jorgefinelli90/minic3portable/imagenes/caja_dibujo_capa1.png

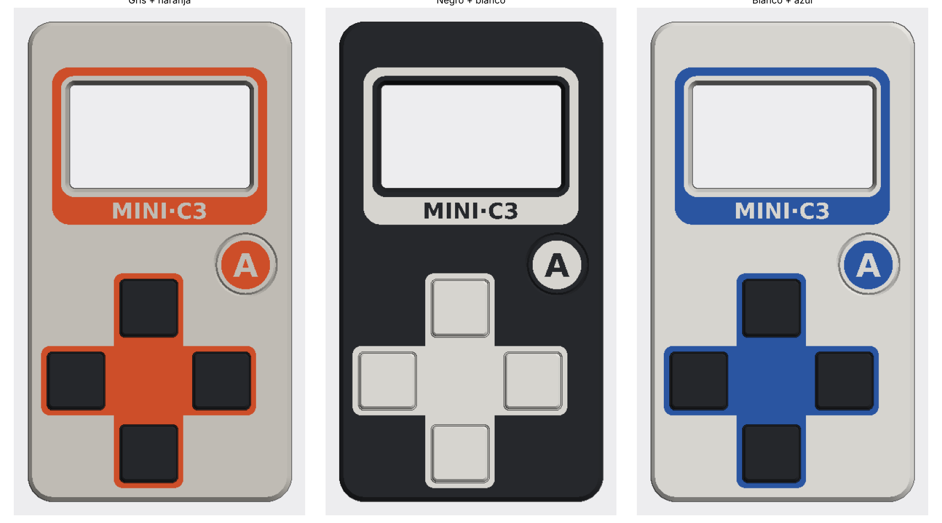
imagenes/caja_dibujo_capa1.png
