jorgefinelli90/minic3portable/imagenes/caja_traba_pulsador.png

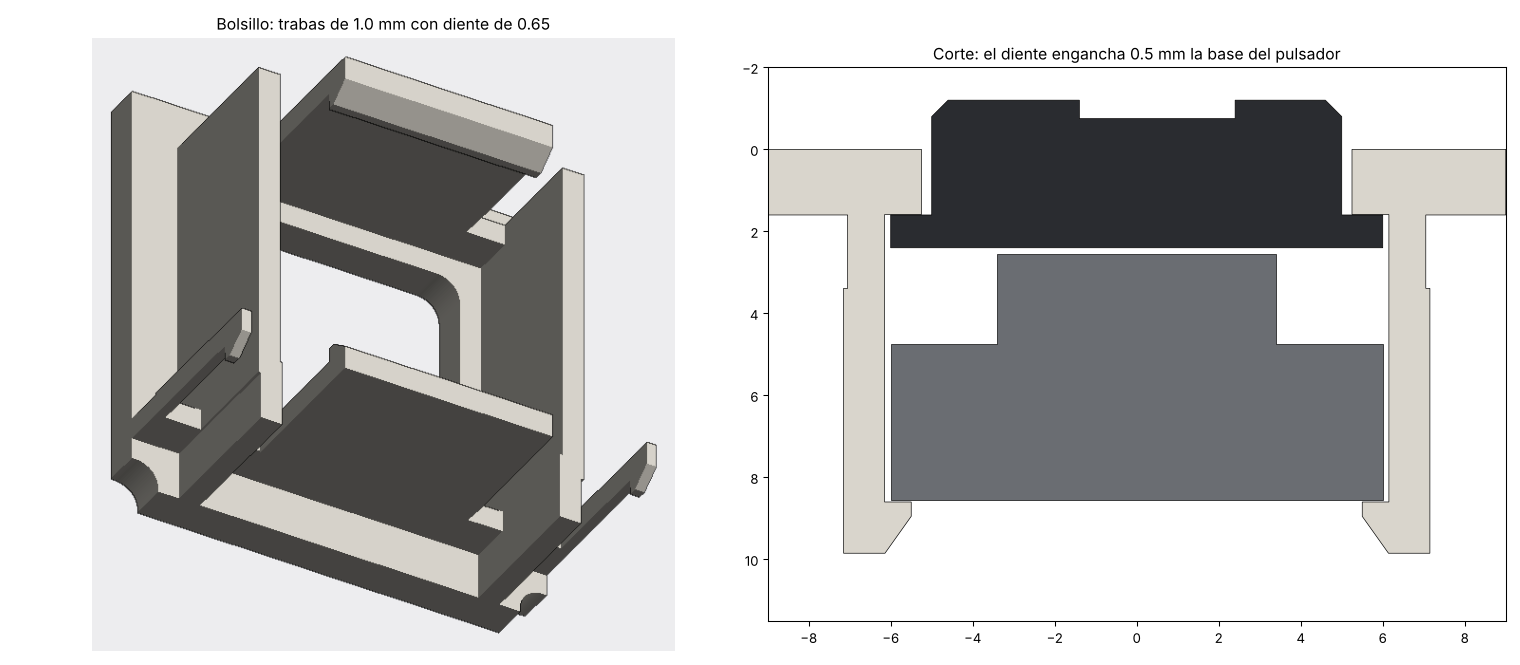
imagenes/caja_traba_pulsador.png
