jorgefinelli90/minic3portable/imagenes/caja_vistas.png

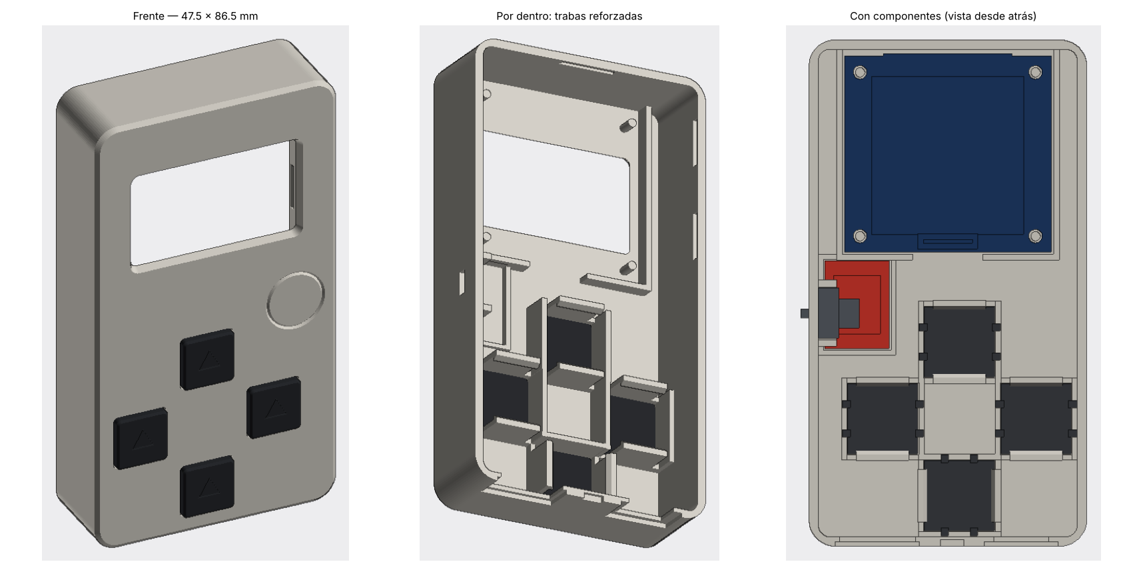
imagenes/caja_vistas.png
