jorgefinelli90/minic3portable/imagenes/foto_mini_c3.jpg

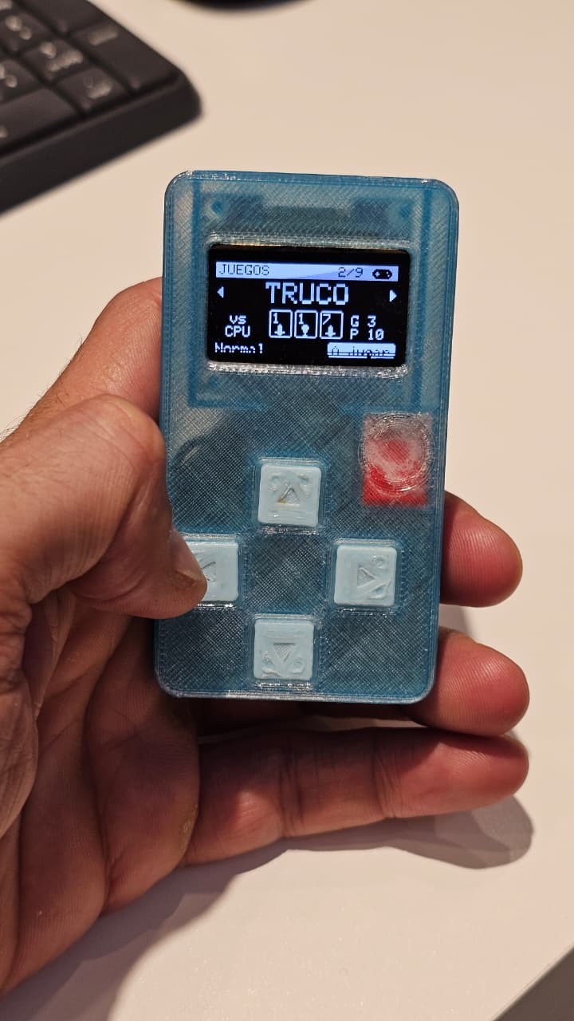
imagenes/foto_mini_c3.jpg
