jorgefinelli90/minic3portable/imagenes/pantallas/arkanoid_juego.gif

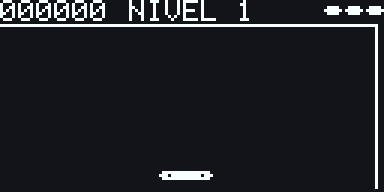
imagenes/pantallas/arkanoid_juego.gif
