jorgefinelli90/minic3portable/imagenes/pantallas/arkanoid_pantallas.png

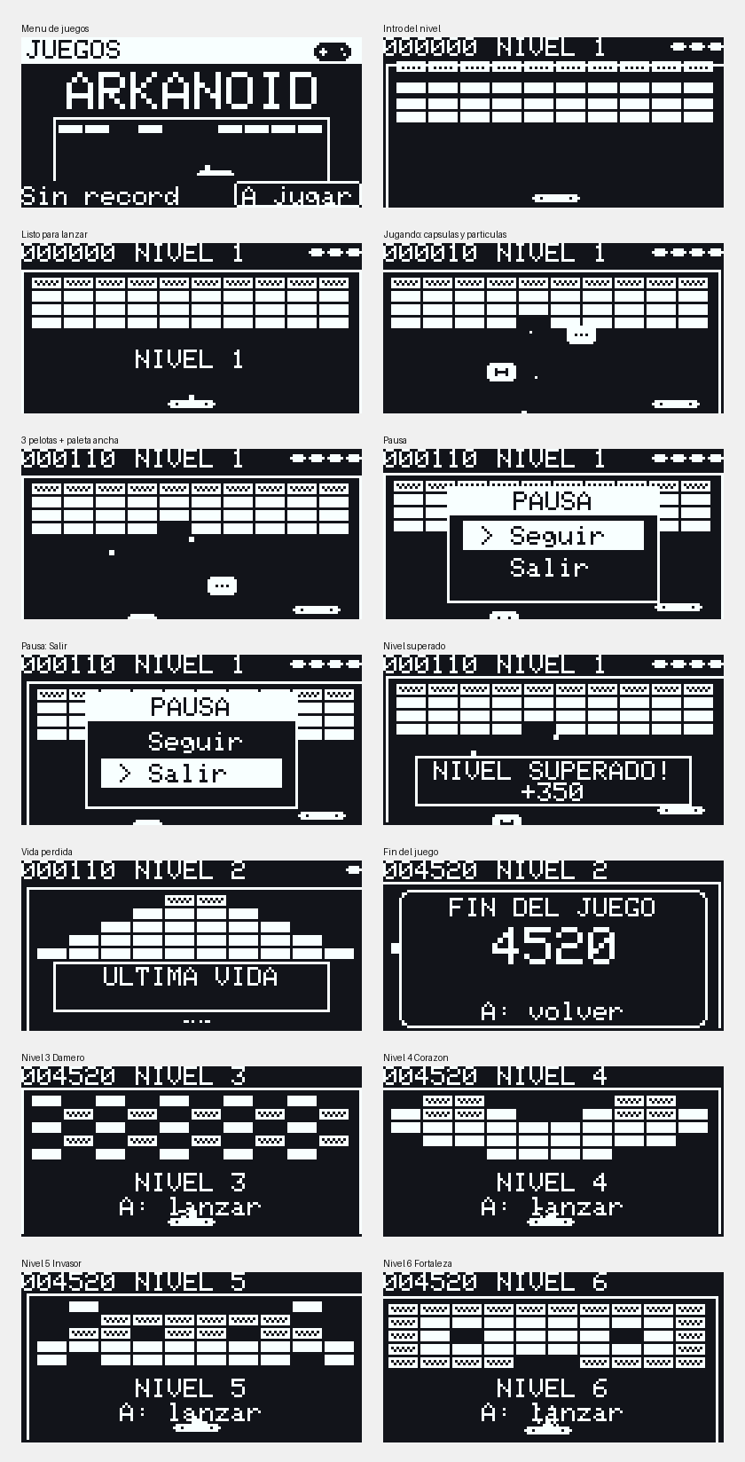
imagenes/pantallas/arkanoid_pantallas.png
