jorgefinelli90/minic3portable/imagenes/pantallas/inicio.gif

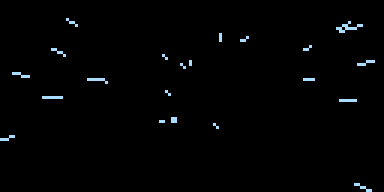
imagenes/pantallas/inicio.gif
