jorgefinelli90/minic3portable/imagenes/pantallas/juegos_v1110.png

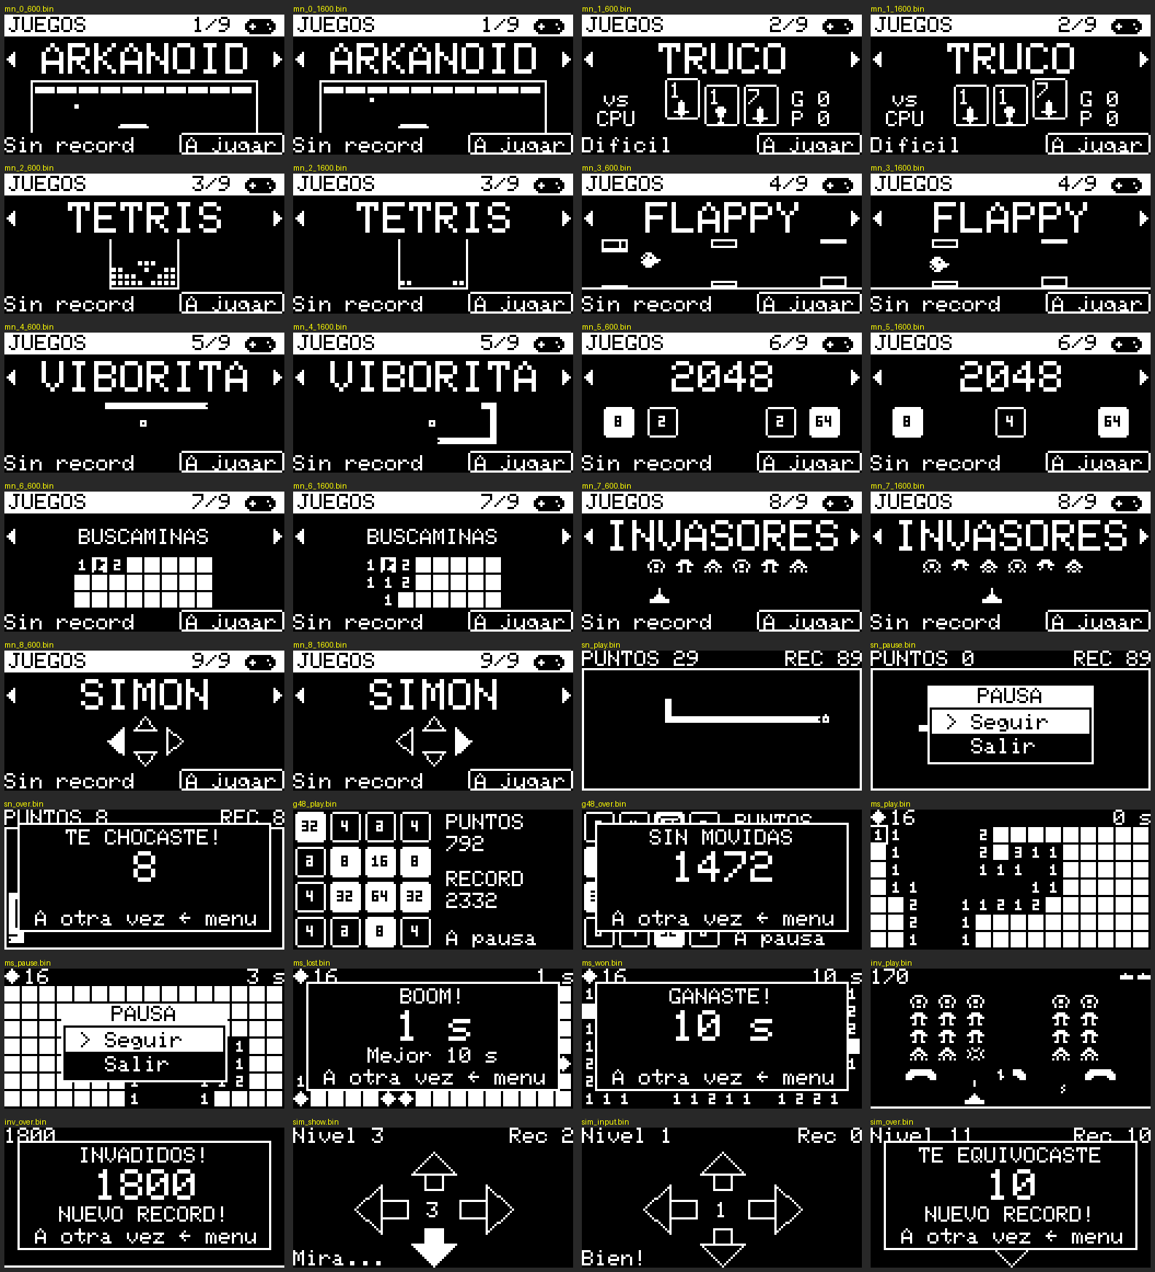
imagenes/pantallas/juegos_v1110.png
