jorgefinelli90/minic3portable/imagenes/pantallas/mensaje_llega.gif

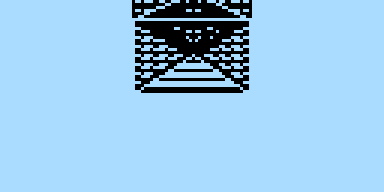
imagenes/pantallas/mensaje_llega.gif
