jorgefinelli90/minic3portable/imagenes/pantallas/mensajes_pantallas.png

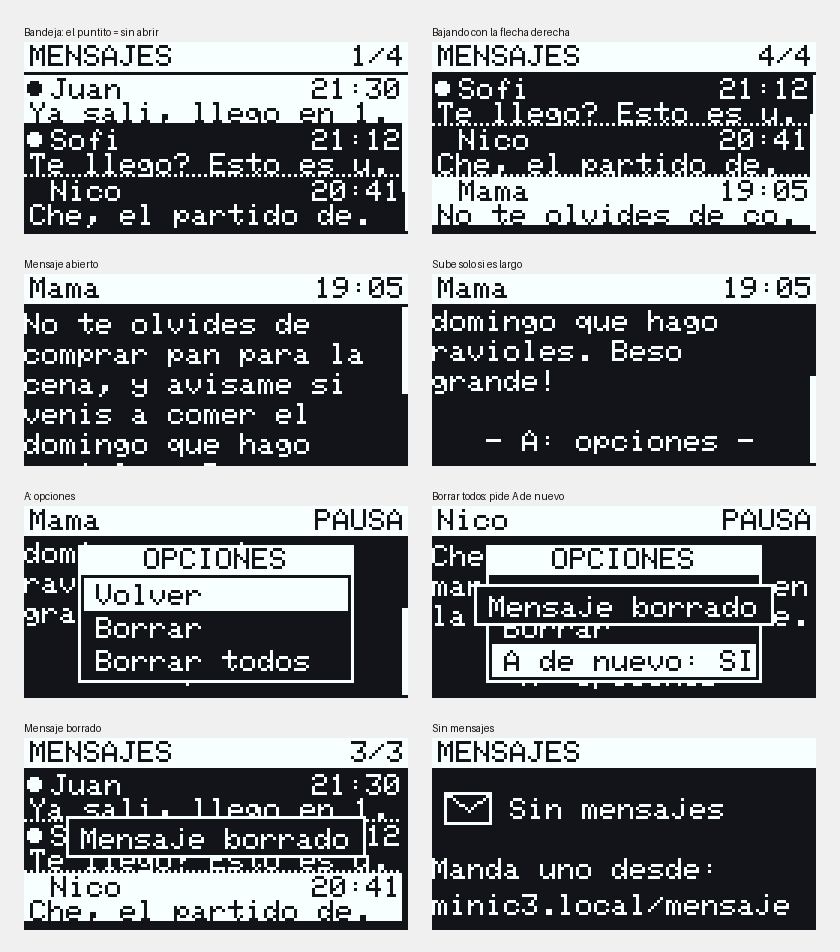
imagenes/pantallas/mensajes_pantallas.png
