jorgefinelli90/minic3portable/imagenes/pantallas/noticias_scroll.gif

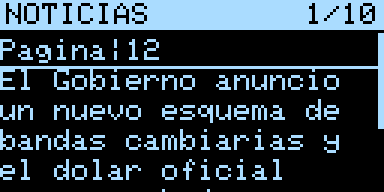
imagenes/pantallas/noticias_scroll.gif
