jorgefinelli90/minic3portable/imagenes/pantallas/panel_equipo.png

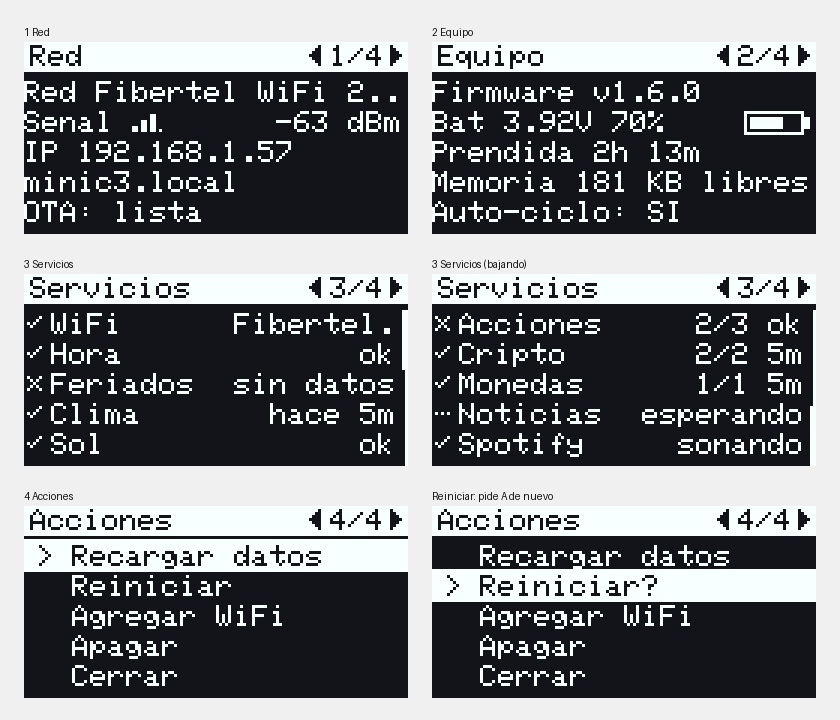
imagenes/pantallas/panel_equipo.png
