jorgefinelli90/minic3portable/imagenes/pantallas/spotify_pantallas.png

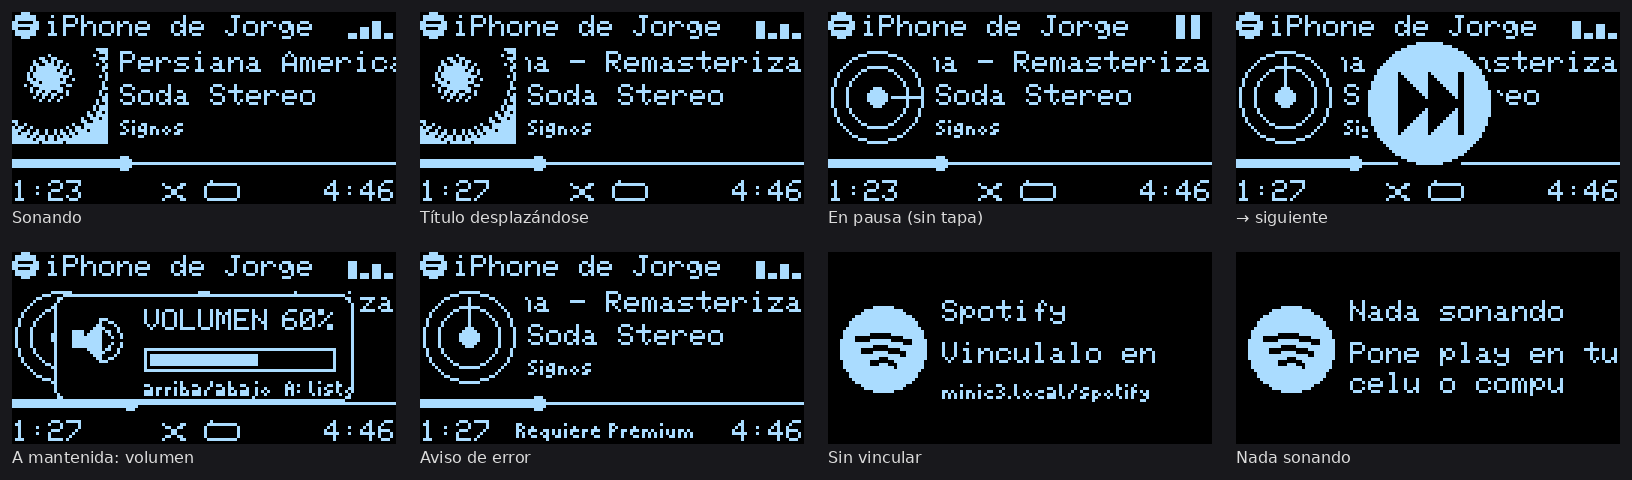
imagenes/pantallas/spotify_pantallas.png
