jorgefinelli90/minic3portable/imagenes/pantallas/tetris_flappy_pantallas.png

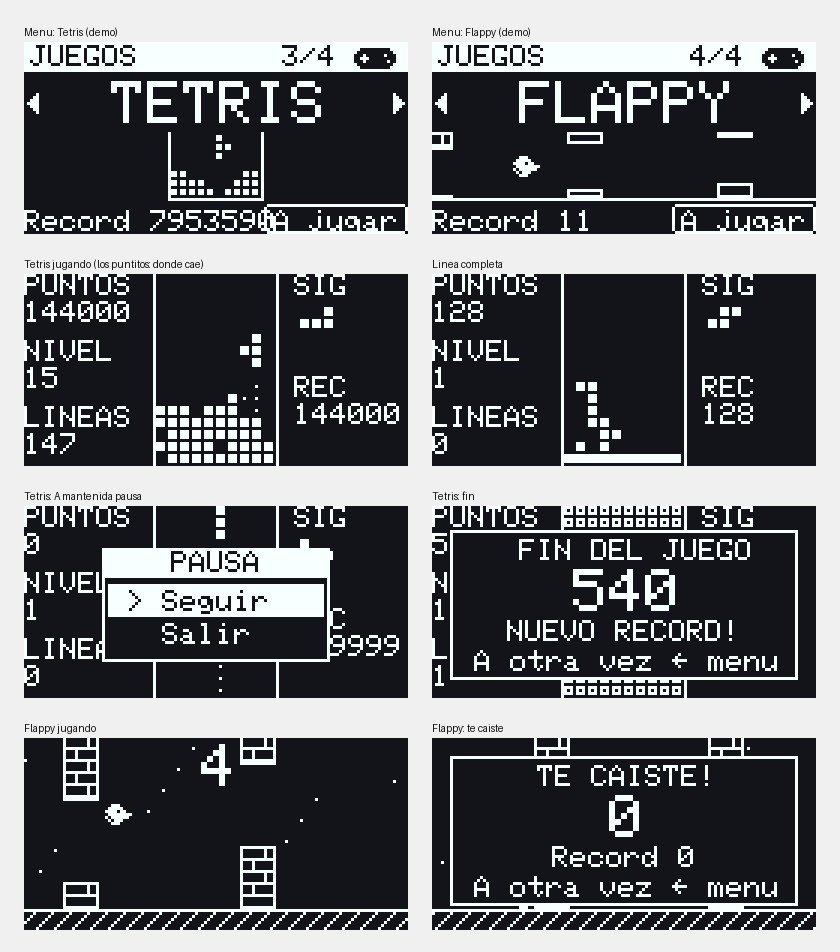
imagenes/pantallas/tetris_flappy_pantallas.png
