jorgefinelli90/minic3portable/imagenes/pantallas/truco_cpu_pantallas.png

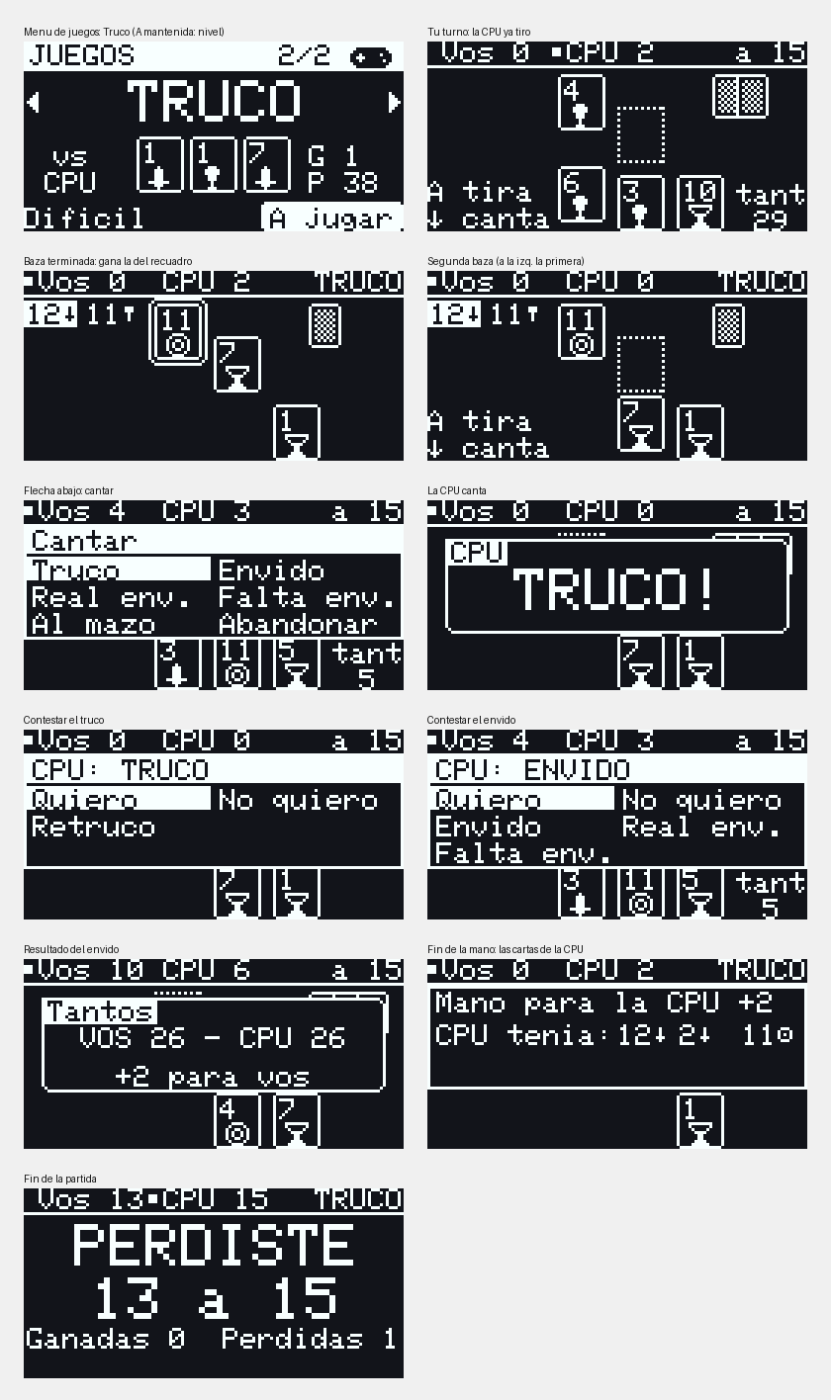
imagenes/pantallas/truco_cpu_pantallas.png
