jorgefinelli90/minic3portable/imagenes/pantallas/truco_pantallas.png

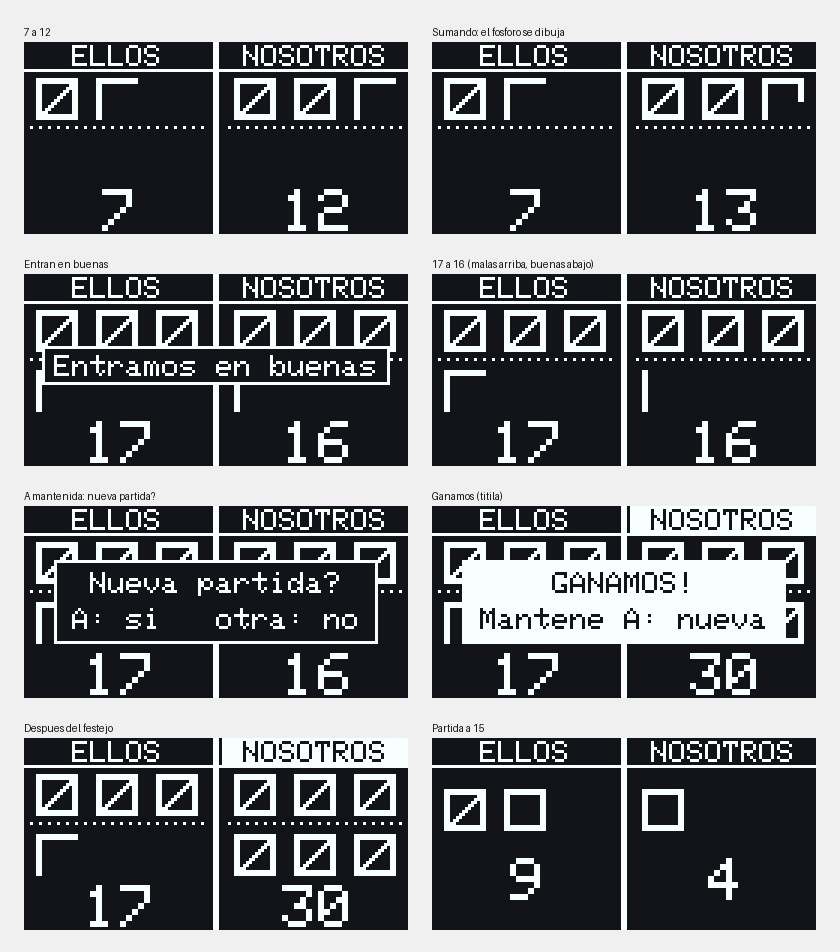
imagenes/pantallas/truco_pantallas.png
