jorgefinelli90/minic3portable/imagenes/portada_3x4.jpg

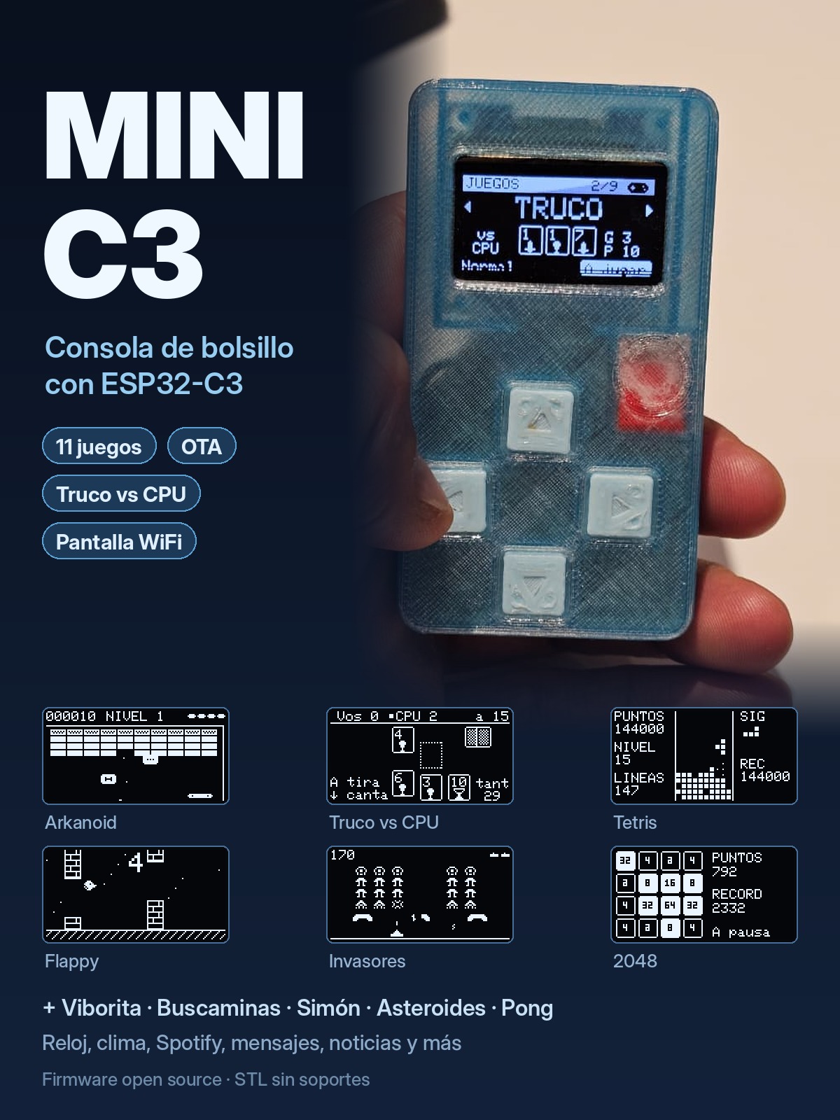
imagenes/portada_3x4.jpg
