jorgefinelli90/minic3portable/imagenes/teclas_encastre.png

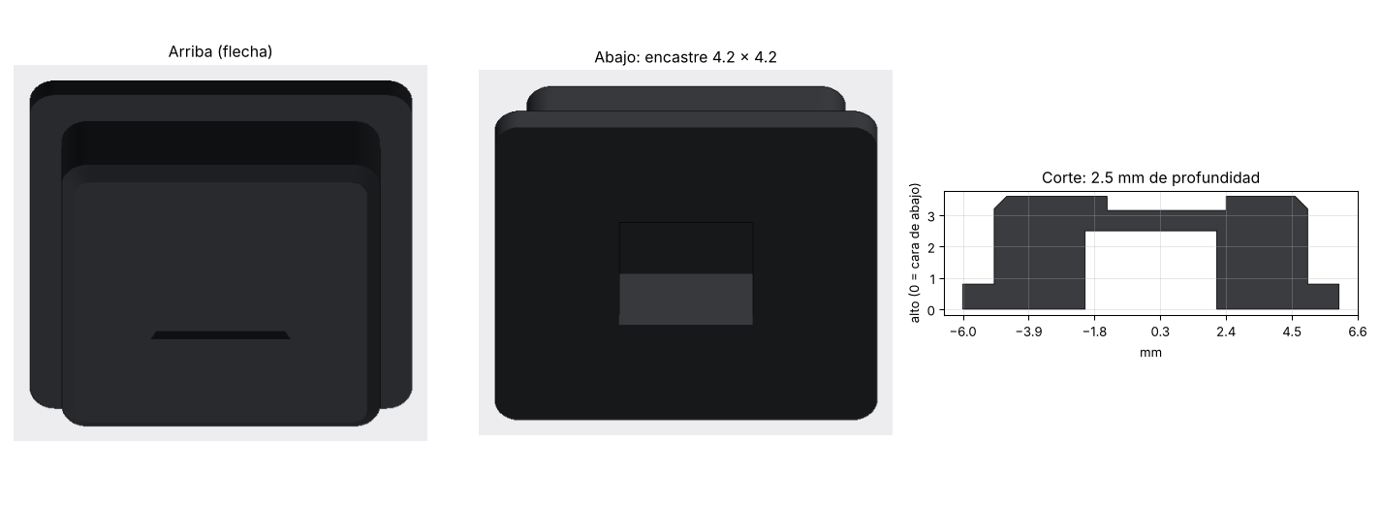
imagenes/teclas_encastre.png
