jorgefinelli90/minic3portable/caja/stl/prueba_oled.stl

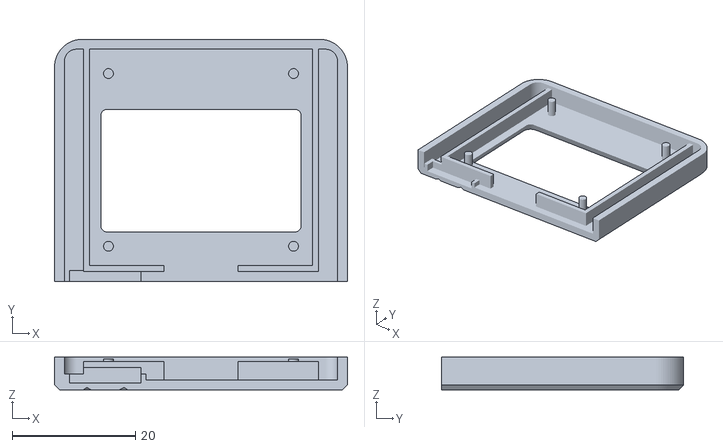
[picture p23: CAD file, 2026-11-11]
caja/stl/prueba_oled.stl
47.5 x 39.3 x 5.30
