jorgefinelli90/minic3portable/caja/stl/teclas_x4_encastre.stl

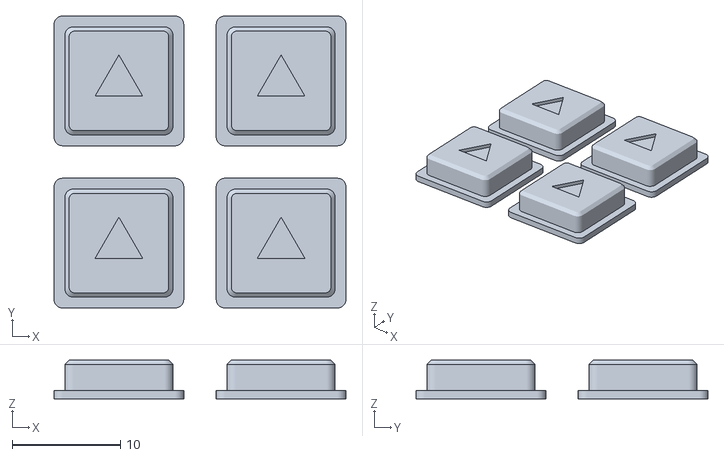
[picture p24: CAD file, 2026-11-11]
caja/stl/teclas_x4_encastre.stl
27.0 x 27.0 x 3.60
