jorgefinelli90/minic3portable/caja/stl/tapa.stl

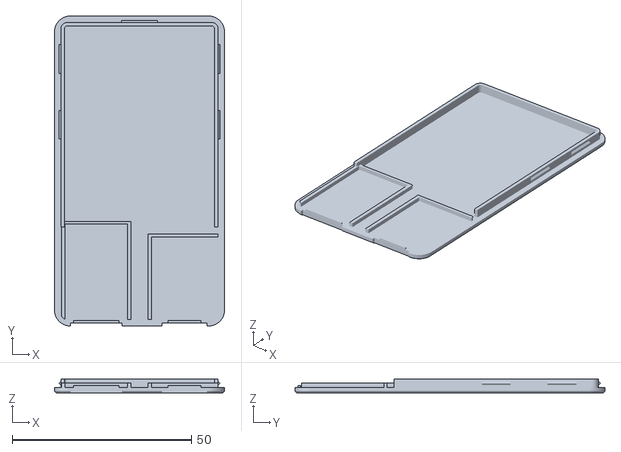
[picture p25: CAD file, 2026-11-11]
caja/stl/tapa.stl
47.5 x 86.5 x 4.00
