jorgefinelli90/minic3portable/caja/stl/caja_frente_4botones.stl

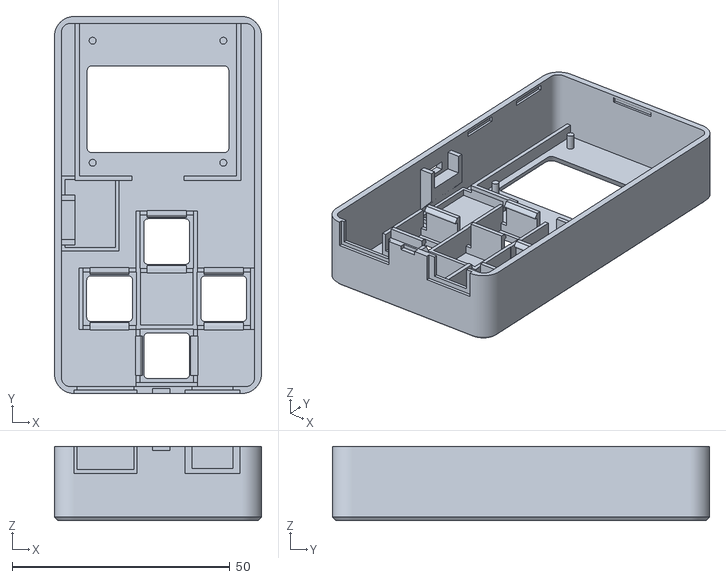
[picture p26: CAD file, 2026-11-11]
caja/stl/caja_frente_4botones.stl
47.5 x 86.5 x 17.0
