jorgefinelli90/minic3portable/caja/stl/prueba_cierre.stl

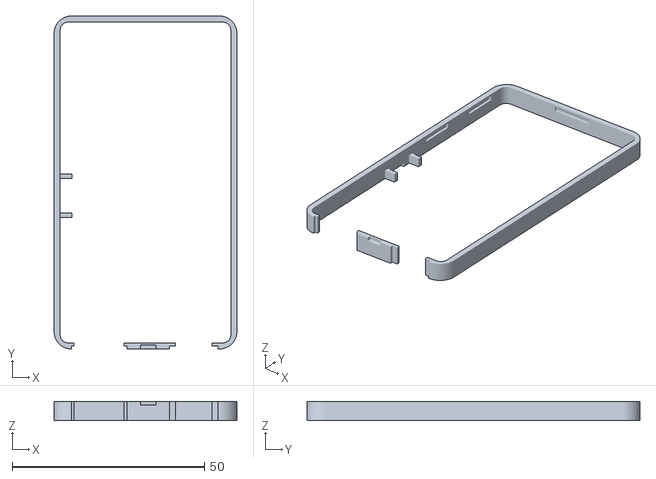
[picture p27: CAD file, 2026-11-11]
caja/stl/prueba_cierre.stl
47.5 x 86.5 x 5.00
