jorgefinelli90/minic3portable/caja/stl/teclas_x4.stl

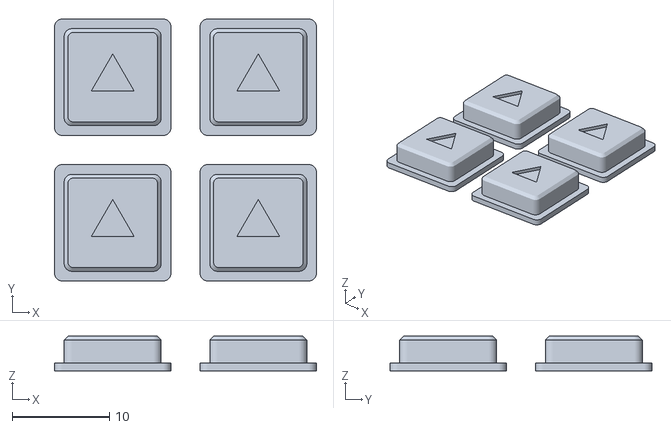
[picture p28: CAD file, 2026-11-11]
caja/stl/teclas_x4.stl
27.0 x 27.0 x 3.60
