jorgefinelli90/minic3portable/caja/stl/prueba_botones_y_tactil.stl

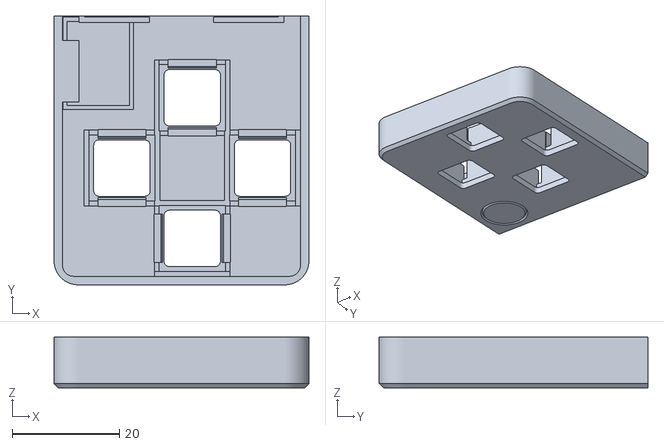
[picture p29: CAD file, 2026-11-11]
caja/stl/prueba_botones_y_tactil.stl
47.5 x 50.0 x 9.45
