jorgefinelli90/minic3portable/caja/stl/dibujo_capa1.stl

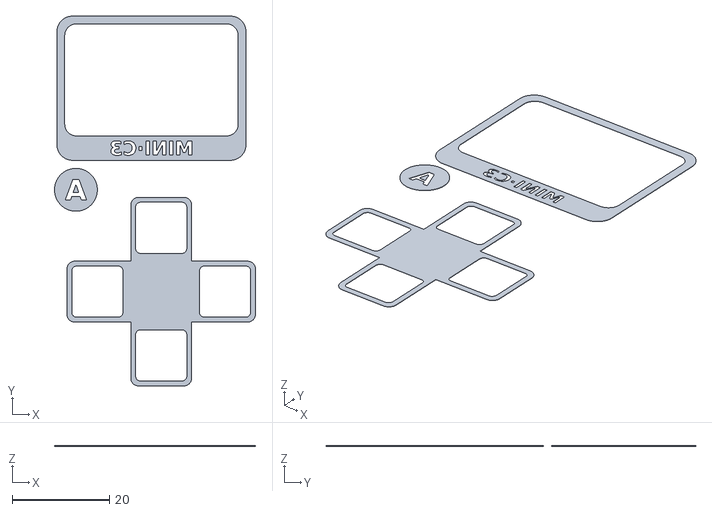
[picture p30: CAD file, 2026-11-11]
caja/stl/dibujo_capa1.stl
41.2 x 75.9 x 0.2
