jorgefinelli90/minic3portable/(list of files, cad)

Other CAD files:
caja/stl/caja_frente_4botones_color.stl
