jorgefinelli90/minic3portable/(commit log)

2026-11-11 Mini C3 v1.11.0: firmware, caja imprimible e imagenes
    Consola de bolsillo ESP32-C3-Zero + OLED SH1106 con 9 juegos, anotador
    de truco y pantalla WiFi. Basado en Tinytosh (Uladzimir Hitsarau, MIT).
    Claude-Session: https://claude.ai/code/session_01JDcRR5CNGLZg8E2uqNEJiz
    [caja_frente_4botones.stl, caja_frente_4botones_color.stl, dibujo_capa1.stl, prueba_botones_y_tactil.stl, prueba_cierre.stl, prueba_oled.stl, tapa.stl, teclas_x4.stl]
2026-11-13 v1.12.0: brillo de pantalla y modo ahorro
    Nueva pagina Ajustes en el panel del equipo (y en el panel web):
    brillo en 5 niveles y modo ahorro (atenua a los 20 s, se suspende
    a los 3 min, CPU a 80 MHz fuera de los juegos, WiFi en modem sleep max).
    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
2026-11-13 v1.13.0: Asteroides y Pong (11 juegos)
    Dos juegos nuevos: Asteroides (nave con inercia, rocas que se parten,
    pantalla que da la vuelta) y Pong contra la compu (partidos a 7, la CPU
    mejora con cada partido ganado; record = racha). En esos dos, mantener la
    flecha arriba no apaga la consola. Portadas y galeria con 11 juegos.
    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
